ikechangexentrick/euclidean_sequencer/README.md

# euclidean_sequencer
Sequencer producing Euclidean rhythm
