ikechangexentrick/euclidean_sequencer/hw/ModuleCore.kicad_pcb

## KiCad design hw/ModuleCore.kicad_pcb (2022-09-08)

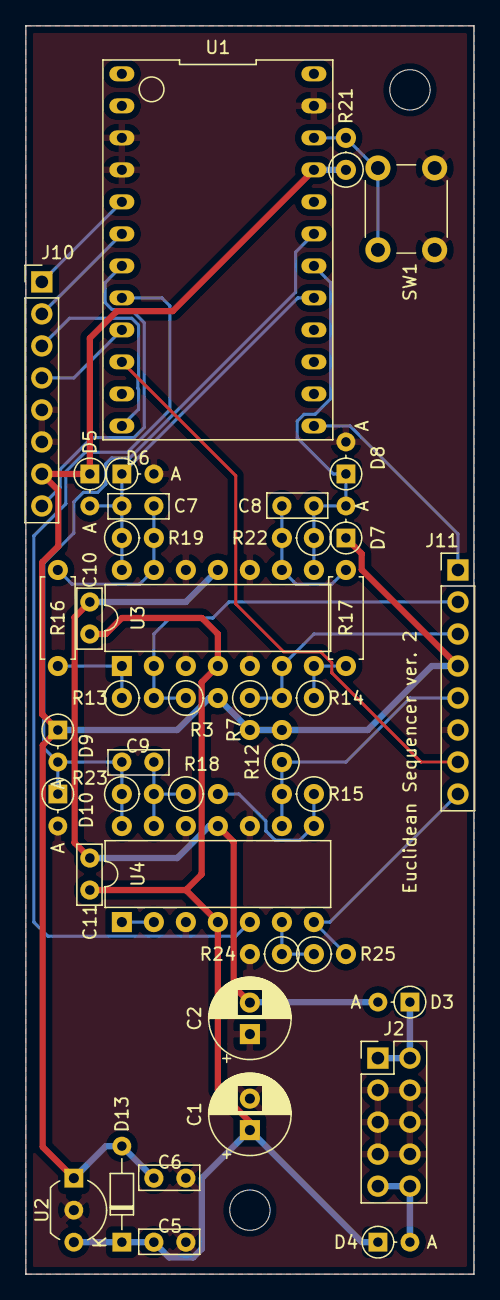
[picture p1: board ModuleCore.kicad_pcb from above]

Board: 2 copper layers, 35.6 x 99.1 mm, 43 parts (0 on the bottom side), 30 nets.

Parts:
C1, C2: 100u; CP_Radial_D6.3mm_P2.50mm
C5, C6, C10, C11: 0.1u; C_Axial_L4.8mm_D2.0mm_P2.54mm_Horizontal
C7, C8, C9: 100p; C_Axial_L4.8mm_D2.0mm_P2.54mm_Horizontal
D3, D4: D_Schottky; D_DO-34_SOD68_P2.54mm_Vertical_AnodeUp
D5, D6, D7, D8, D9, D10: 1N4148; D_DO-34_SOD68_P2.54mm_Vertical_AnodeUp
D13: 1N4148; D_DO-34_SOD68_P7.62mm_Horizontal
J2: power_bus; PinHeader_2x05_P2.54mm_Vertical
J10: Conn_Left; PinHeader_1x08_P2.54mm_Vertical
J11: Conn_Right; PinHeader_1x08_P2.54mm_Vertical
R3, R7, R12, R13, R14, R15: 100k; R_Axial_DIN0207_L6.3mm_D2.5mm_P2.54mm_Vertical
R16, R17: 10k; R_Axial_DIN0207_L6.3mm_D2.5mm_P7.62mm_Horizontal
R18, R21: 10k; R_Axial_DIN0207_L6.3mm_D2.5mm_P2.54mm_Vertical
R19, R22, R23: 4.7k; R_Axial_DIN0207_L6.3mm_D2.5mm_P2.54mm_Vertical
R24: 820; R_Axial_DIN0207_L6.3mm_D2.5mm_P2.54mm_Vertical
R25: 1.5k; R_Axial_DIN0207_L6.3mm_D2.5mm_P2.54mm_Vertical
SW1: reset; SW_PUSH_6mm
U1: ProMicro; Pro_Micro_Top_side_Up
U2: LM78L05_TO92; TO-92_Inline_Wide
U3, U4: TL074; DIP-14_W7.62mm
e: MountingHole_3.2mm_M3
e#2: MountingHole_3.2mm_M3

Connections:
+5V: C6.1, D5.1, D7.1, D9.1, D13.2, J10.7, J11.4, R3.2, R7.2, R12.2, R21.1, U1.21, U2.1
+12V: C1.1, C5.1, C10.1, C11.1, D4.1, D13.1, U2.3, U3.4, U4.4
-12V: C2.2, C10.2, C11.2, D3.2, U3.11, U4.11
/_module_core/beat: U1.8, U4.5
/_module_core/beat_out: J11.8, R25.2, U4.7
/_module_core/btn_enter: J10.3, U1.12
/_module_core/clock: J11.7, U1.10
/_module_core/cv_len: C7.2, D5.2, D6.1, R19.1, U1.17, U3.14
/_module_core/cv_len_in: J11.2, R3.1, R13.2, U3.2
/_module_core/cv_num: C8.2, D7.2, D8.1, R22.1, U1.18, U3.8
/_module_core/cv_num_in: J11.3, R7.1, R14.2, U3.6
/_module_core/cv_select_in: J10.8, U1.7
/_module_core/cv_sft: C9.2, D9.2, D10.1, R23.1, U1.19, U4.14
/_module_core/cv_sft_in: J11.5, R12.1, R15.2, U4.9
/_module_core/rsw_1: J11.1, U1.13
/_module_core/rsw_2: J10.4, U1.9
/_module_core/scl: J10.2, U1.6
/_module_core/sda: J10.1, U1.5
GND: C1.2, C2.1, C5.2, C6.2, D6.2, D8.2, D10.2, J2.3, J2.4, J2.5, J2.6, J2.7, J2.8, J10.5, J10.6, J11.6, R24.2, SW1.2, U1.3, U1.4, U1.23, U2.2, U3.3, U3.5, U3.10, U3.12, U4.3, U4.10, U4.12
unnamed: C7.1, R16.1, R19.2, U3.13
unnamed: C8.1, R17.1, R22.2, U3.9
unnamed: C9.1, R18.1, R23.2, U4.13
unnamed: D3.1, J2.1, J2.2
unnamed: D4.2, J2.9, J2.10
unnamed: R13.1, R16.2, U3.1
unnamed: R14.1, R17.2, U3.7
unnamed: R15.1, R18.2, U4.8
unnamed: R21.2, SW1.1, U1.22
unnamed: R24.1, R25.1, U4.6
unnamed: U4.1, U4.2
