ikechangexentrick/euclidean_sequencer/hw/ModuleInterface.kicad_pcb

## KiCad design hw/ModuleInterface.kicad_pcb (2022-09-08)

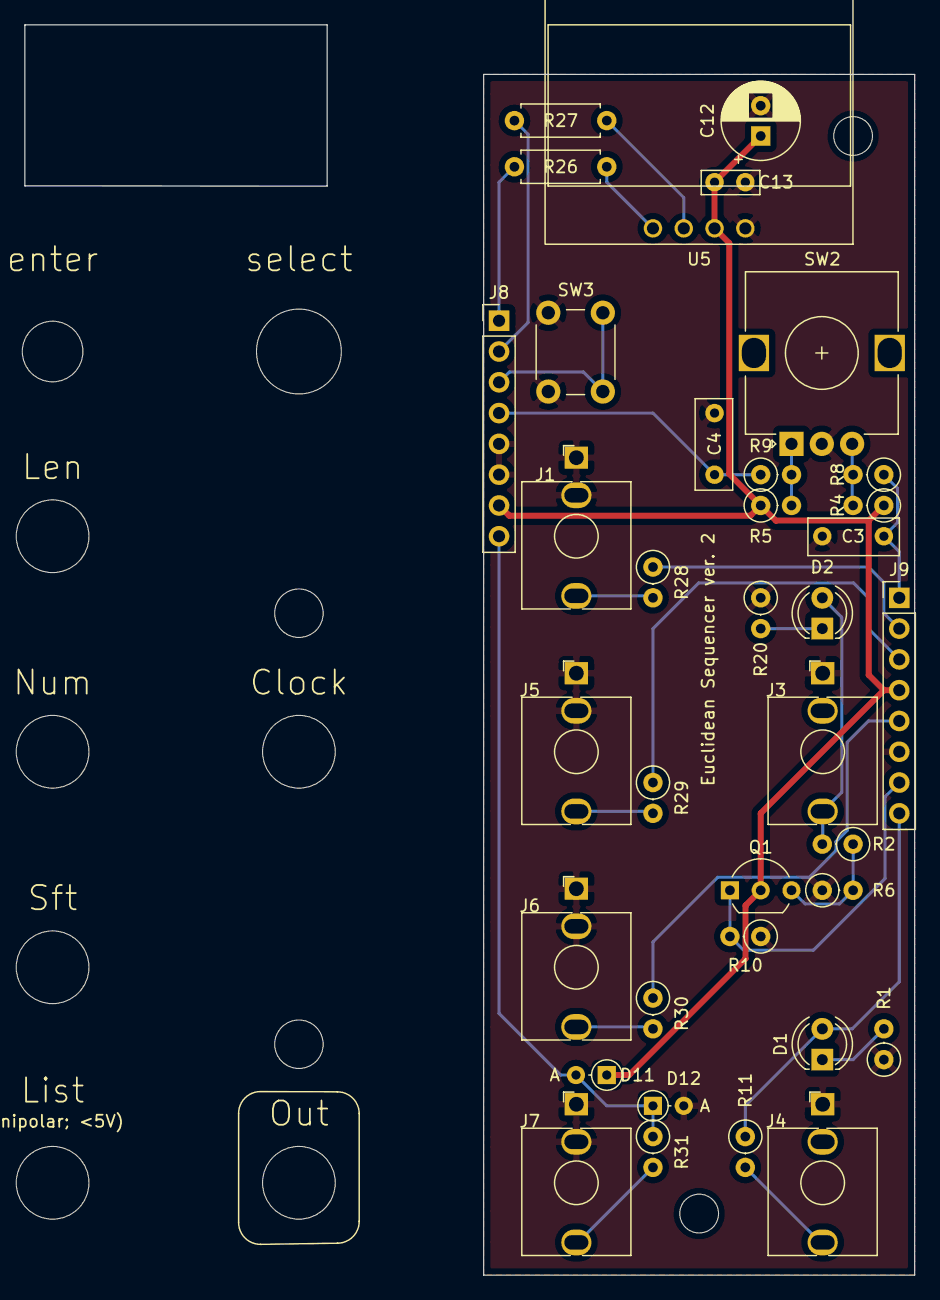
[picture p2: board ModuleInterface.kicad_pcb from above]

Board: 2 copper layers, 35.6 x 99.1 mm, 44 parts (0 on the bottom side), 26 nets.

Parts:
C3, C4: 0.1u; C_Axial_L4.8mm_D3.1mm_P5.08mm_Horizontal
C12: 100u; CP_Radial_D6.3mm_P2.50mm
C13: 0.1u; C_Axial_L4.8mm_D2.0mm_P2.54mm_Horizontal
Clock: annotation_3.5mm_jack_in
D1: led_beat; LED_D4.0mm
D2: led_clock; LED_D4.0mm
D11, D12: 1N4148; D_DO-34_SOD68_P2.54mm_Vertical_AnodeUp
J1: CV_len; mono_jack_3.5mm
J3: clock_in; mono_jack_3.5mm
J4: beat_out; mono_jack_3.5mm
J5: CV_num; mono_jack_3.5mm
J6: CV_sft; mono_jack_3.5mm
J7: CV_select; mono_jack_3.5mm
J8: Conn_Left; PinHeader_1x08_P2.54mm_Vertical
J9: Conn_Right; PinHeader_1x08_P2.54mm_Vertical
Len: annotation_3.5mm_jack_in
List: annotation_3.5mm_jack_in
Num: annotation_3.5mm_jack_in
Out: annotation_3.5mm_jack_out
Q1: 2SC1815; TO-92_Inline_Wide
R1, R4, R5, R8, R9, R20: 10k; R_Axial_DIN0207_L6.3mm_D2.5mm_P2.54mm_Vertical
R2, R6, R10, R28, R29, R30, R31: 100k; R_Axial_DIN0207_L6.3mm_D2.5mm_P2.54mm_Vertical
R11: 1k; R_Axial_DIN0207_L6.3mm_D2.5mm_P2.54mm_Vertical
R26, R27: 1k; R_Axial_DIN0207_L6.3mm_D2.5mm_P7.62mm_Horizontal
SW2: Rotary_Encoder; RotaryEncoder_Alps_EC12E_Vertical_H20mm
SW3: enter; SW_PUSH_6mm
Sft: annotation_3.5mm_jack_in
U5: OLED_Display_SSD1306; aki_OLED_0.96in
enter: MountingHole_5mm
select: annotation_7mm

Connections:
+5V: C12.1, C13.2, D11.1, J8.7, J9.4, Q1.2, R4.1, R5.1, U5.2
/_module_interface/beat_out: D1.2, J9.8, R11.1
/_module_interface/btn_enter: J8.3, SW3.2
/_module_interface/clock: J9.7, Q1.1, R10.2
/_module_interface/cv_len_in: J9.2, R28.1
/_module_interface/cv_num_in: J9.3, R29.1
/_module_interface/cv_select_in: D11.2, D12.1, J8.8, R31.1
/_module_interface/cv_sft_in: J9.5, R30.1
/_module_interface/rsw_1: C3.1, J9.1, R8.1
/_module_interface/rsw_2: C4.1, J8.4, R9.1
/_module_interface/scl: J8.2, R27.1
/_module_interface/sda: J8.1, R26.1
GND: C3.2, C4.2, C12.2, C13.1, D12.2, J1.S, J1.TN, J3.S, J4.S, J5.S, J5.TN, J6.S, J6.TN, J7.S, J7.TN, J8.5, J8.6, J9.6, R1.1, R6.1, R10.1, R20.1, SW2.C, SW3.1, U5.1
unnamed: D1.1, R1.2
unnamed: D2.1, R20.2
unnamed: D2.2, J3.T, R2.2
unnamed: J1.T, R28.2
unnamed: J4.T, R11.2
unnamed: J5.T, R29.2
unnamed: J6.T, R30.2
unnamed: J7.T, R31.2
unnamed: Q1.3, R2.1, R6.2
unnamed: R4.2, R8.2, SW2.B
unnamed: R5.2, R9.2, SW2.A
unnamed: R26.2, U5.4
unnamed: R27.2, U5.3
