ikechangexentrick/euclidean_sequencer/(commit log)

2022-09-08 Button, rotary encoder, and subclasses are moved to library/button.
    7-segment display is now supported.
    At the first beat, decimal point is on.
2022-09-08 Euclidean Sequencer, ver. 2
    [EuclideanSequencer.sch, ModuleCore.kicad_pcb, ModuleCore.sch, ModuleInterface.kicad_pcb, ModuleInterface.sch, _module_core.sch, _module_interface.sch]
2022-09-19 worked on the PCB. - adjusted CV scale parameters - removed debug code
    [_module_core.sch, _module_interface.sch]
